jacksterb1234/Flight-Controller/Flight_Controller/Project_Outputs/Flight_Controller.pdf

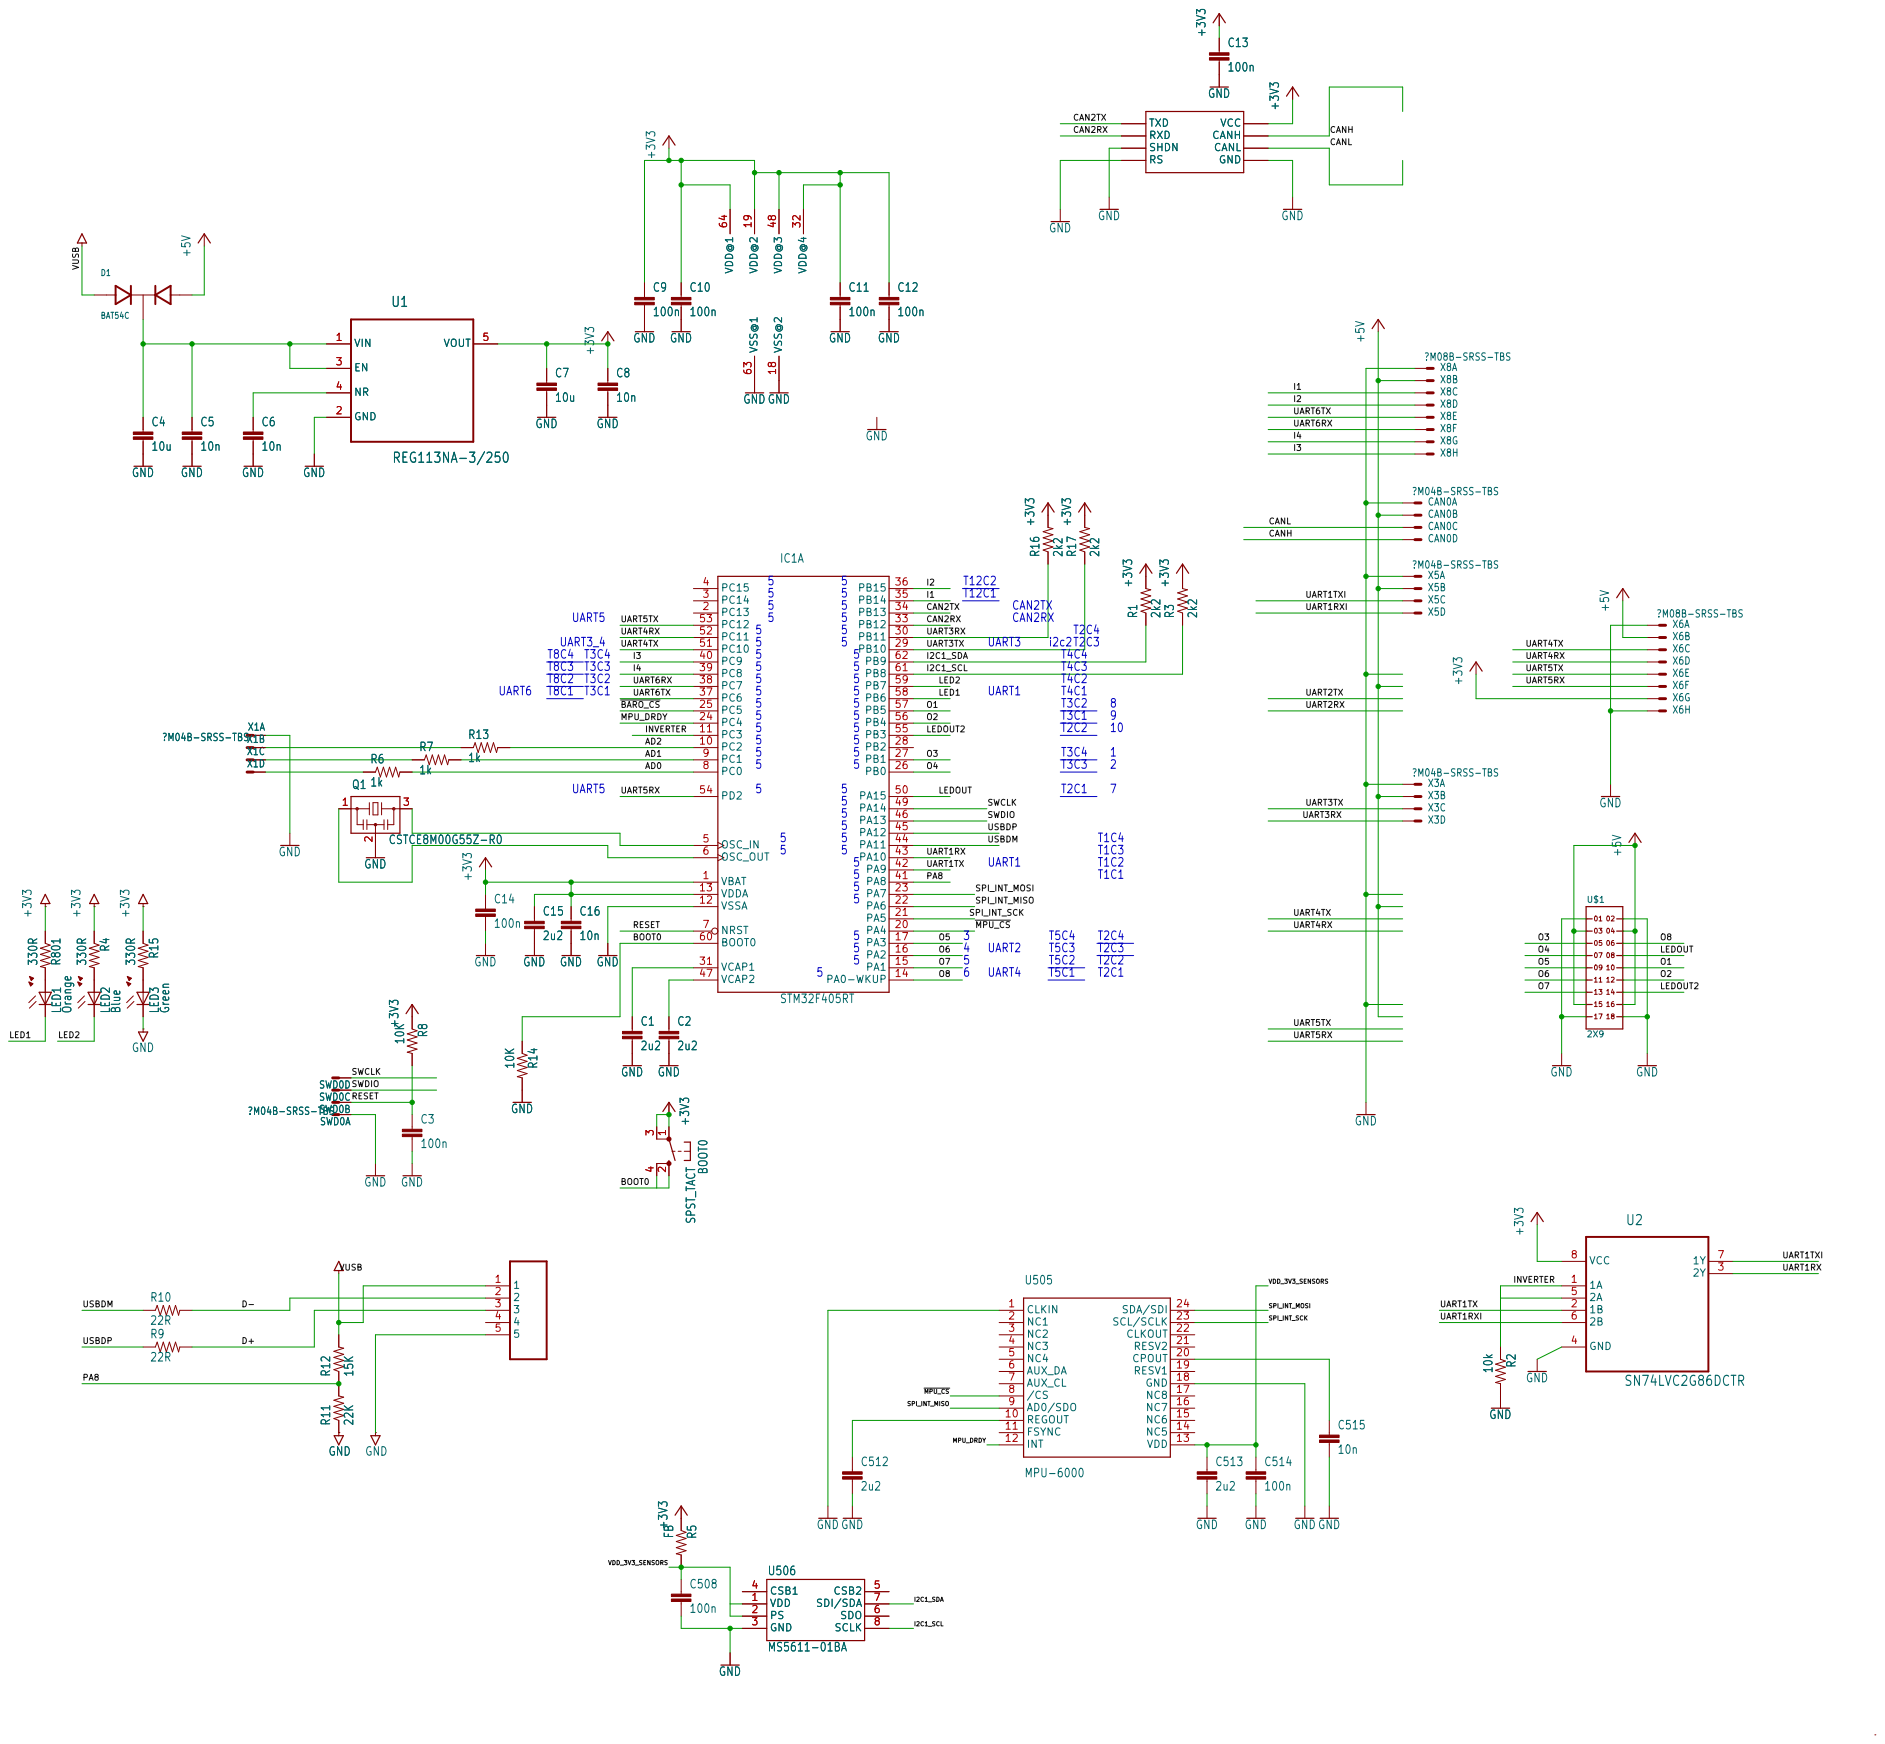
[picture p1: page 1]
