jacksterb1234/Flight-Controller/Flight_Controller/Flight_Controller.kicad_pcb

## KiCad design Flight_Controller/Flight_Controller.kicad_pcb (2026-09-02)

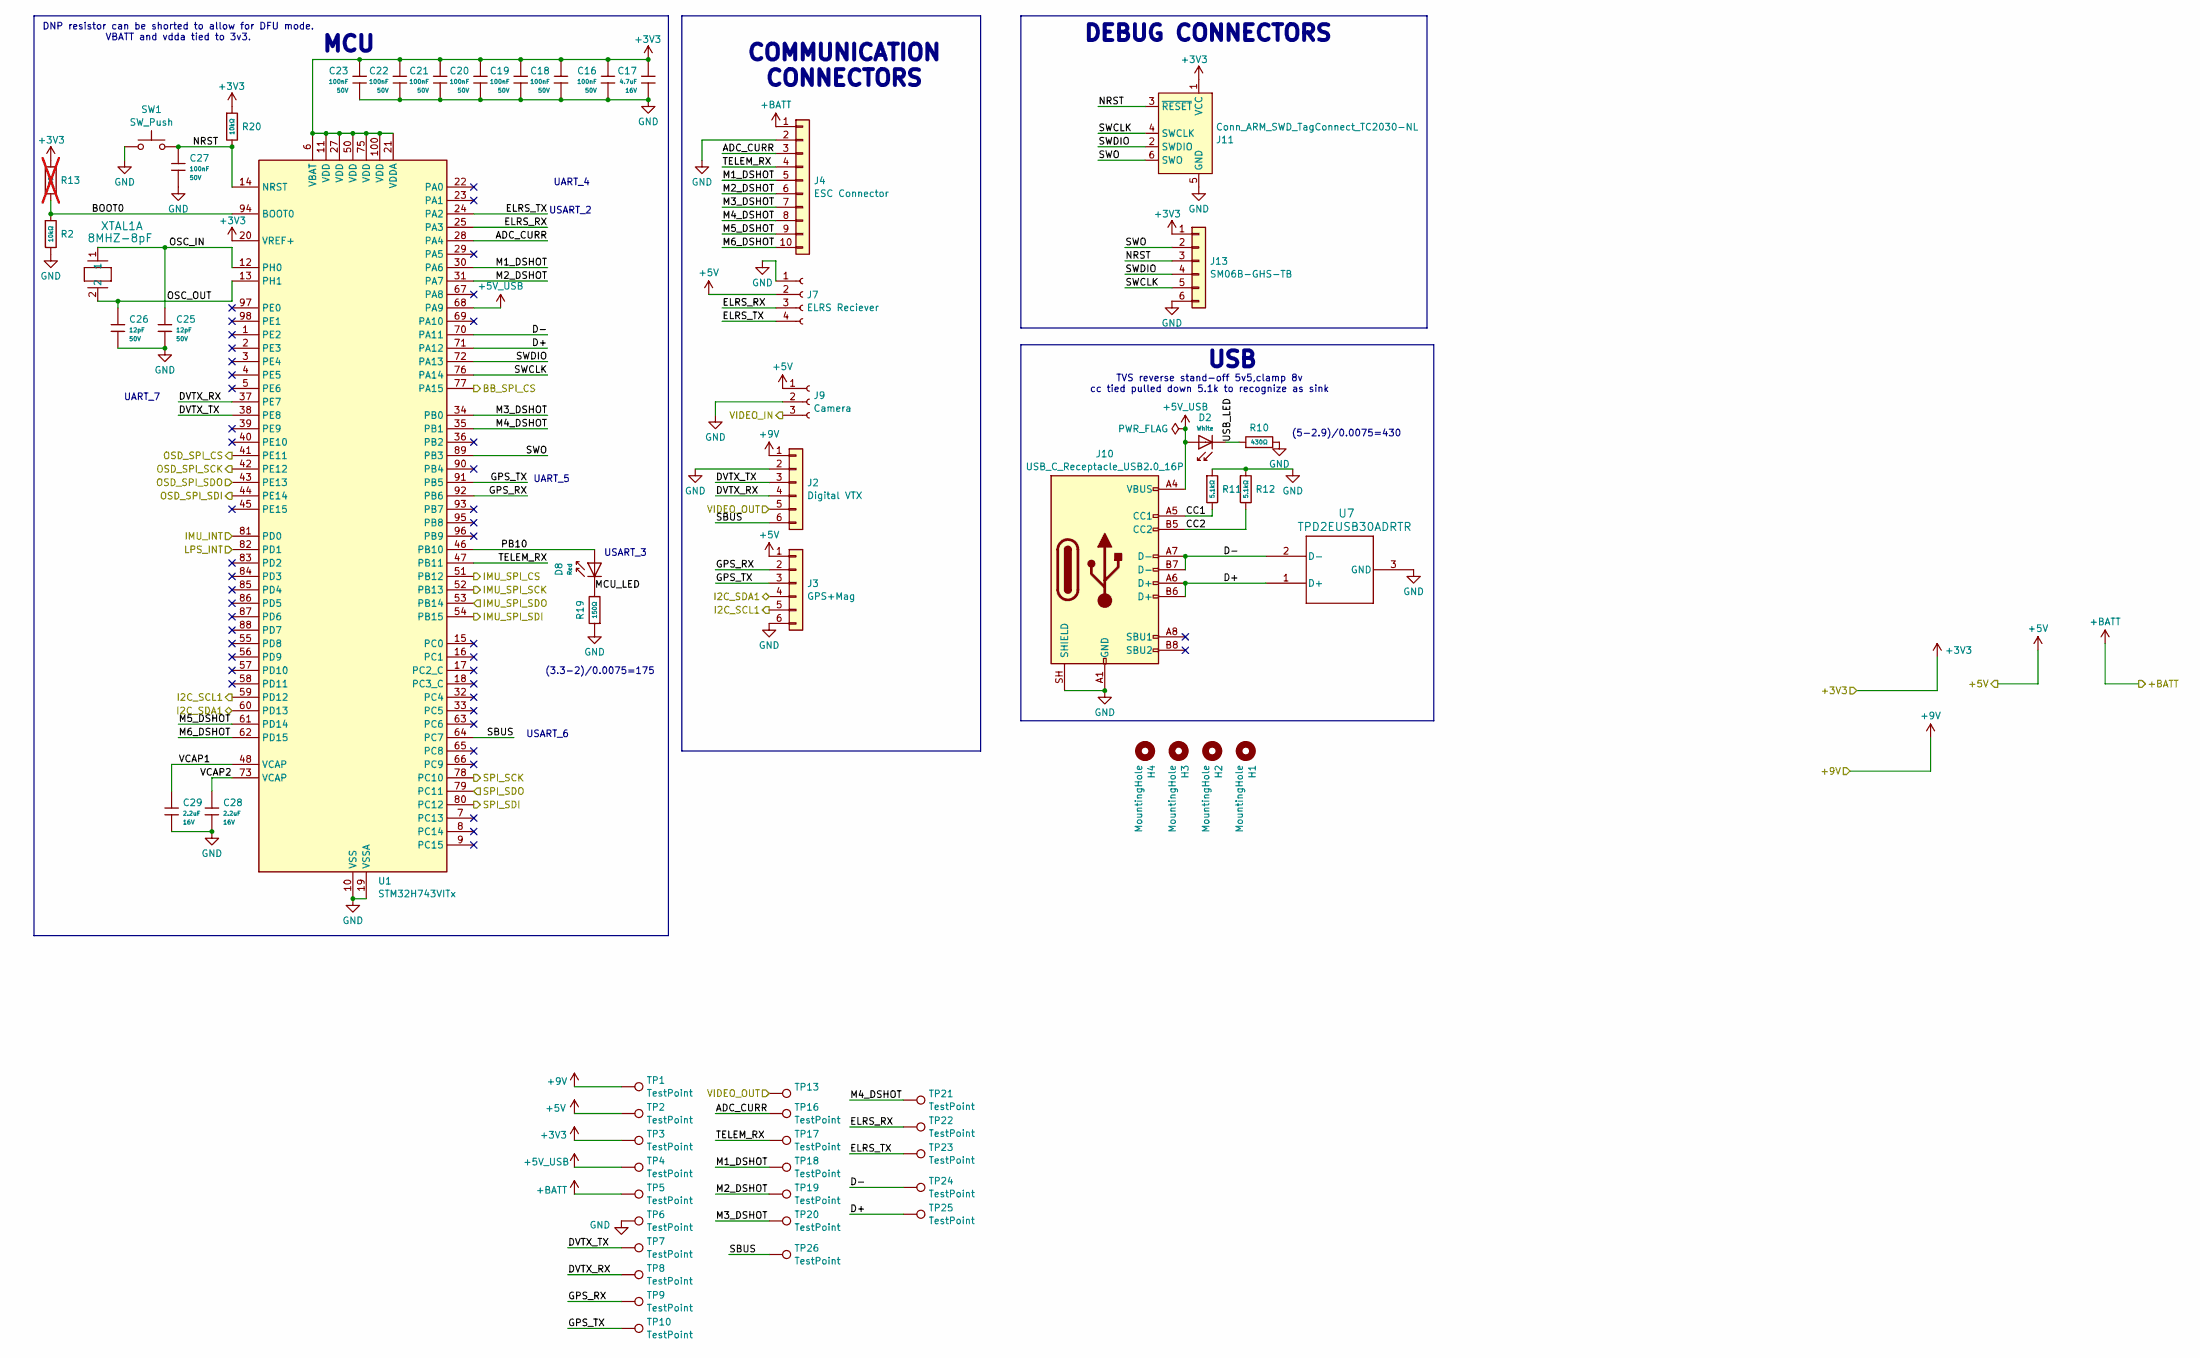
[picture p2: schematic MCU.kicad_sch]

Parts:
C16, C18, C19, C20, C21, C22, C23, C27: 100nF; C_0603; Voltage Rated 50V; Tolerance ±10%; Part CC0603KRX7R9BB104; LCSC C14663
C17: 4.7uF; C_0603; Voltage Rated 16V; Tolerance ±10%; Part CL10A475KO8NNNC; LCSC C19666
C25, C26: 12pF; C_0603; Voltage Rated 50V; Tolerance ±5%; Part CL10C120JB8NNNC; LCSC C38523
C28, C29: 2.2uF; C_0603; Voltage Rated 16V; Tolerance ±10%; Part CL10A225KO8NNNC; LCSC C23630
D2: White; D_0603; Part KT-0603W; LCSC C2290
D8: Red; D_0603; Part KT-0603R; LCSC C2286
H1, H2, H3, H4: MountingHole; MountingHole_3.2mm_M3_Pad_Via
J2: Digital VTX; JST_SH_SM06B-SRSS-TB_1x06-1MP_P1.00mm_Horizontal
J3: GPS+Mag; JST_SH_SM06B-SRSS-TB_1x06-1MP_P1.00mm_Horizontal
J4: ESC Connector; JST_SH_SM10B-SRSS-TB_1x10-1MP_P1.00mm_Horizontal
J7: ELRS Reciever; JST_SH_SM04B-SRSS-TB_1x04-1MP_P1.00mm_Horizontal
J9: Camera; JST_SH_SM03B-SRSS-TB_1x03-1MP_P1.00mm_Horizontal
J10: USB_C_Receptacle_USB2.0_16P; USB_C_Receptacle_GCT_USB4110
J11: Conn_ARM_SWD_TagConnect_TC2030-NL; Tag-Connect_TC2030-IDC-NL_2x03_P1.27mm_Vertical
J13: SM06B-GHS-TB; JST_GH_SM06B-GHS-TB_1x06-1MP_P1.25mm_Horizontal
R2, R20: 10kΩ; R_0603; Overload Voltage (Max) 75V; Tolerance ±1%; Part 0603WAF1002T5E; LCSC C25804
R10: 430Ω; R_0603; Overload Voltage (Max) 75V; Tolerance ±1%; Part 0603WAF4300T5E; LCSC C23170
R11, R12: 5.1kΩ; R_0603; Overload Voltage (Max) 75V; Tolerance ±1%; Part 0603WAF5101T5E; LCSC C23186
R13: 0Ω; R_0603; Overload Voltage (Max) 75V; Tolerance ±1%; Part 0603WAF0000T5E; LCSC C21189; not fitted
R19: 150Ω; R_0603; Overload Voltage (Max) 75V; Tolerance ±1%; Part 0603WAF1500T5E; LCSC C22808
SW1: SW_Push; SW_TS-1088-AR02016
TP1, TP2, TP3, TP4, TP5, TP6, TP7, TP8, TP9, TP10, TP13, TP16, TP17, TP18, TP19, TP20, TP21, TP22, TP23, TP24, TP25, TP26: TestPoint; TestPoint_Pad_D1.0mm
U1: STM32H743VITx; LQFP-100_14x14mm_P0.5mm
U7: TPD2EUSB30ADRTR; DRT3-L
XTAL1: 8MHZ-8pF; XTAL_NX3225GD-8MHZ-STD-CRA-3_NDK-L

Connections:
+3V3: C16.1, C17.1, C18.1, C19.1, C20.1, C21.1, C22.1, C23.1, J11.1 (VCC), J13.1, R13.1, R20.1, TP3.1 (1_1), U1.6 (VBAT), U1.11 (VDD), U1.20 (VREF+), U1.21 (VDDA), U1.27 (VDD), U1.50 (VDD), U1.75 (VDD), U1.100 (VDD); also elsewhere on the board
+5V: J3.1, J7.2, J9.1, TP2.1 (1_1); also elsewhere on the board
+5V_USB: D2.2, J10.A4 (VBUS), J10.A9 (VBUS), J10.B4 (VBUS), J10.B9 (VBUS), TP4.1 (1_1), U1.68 (PA9)
+9V: J2.1, TP1.1 (1_1); also elsewhere on the board
+BATT: J4.1, TP5.1 (1_1); also elsewhere on the board
/MCU/Connectors/ADC_CURR: J4.3, TP16.1 (1_1), U1.28 (PA4)
/MCU/Connectors/BB_SPI_CS: U1.77 (PA15); also elsewhere on the board
/MCU/Connectors/BOOT0: R2.1, R13.2, U1.94 (BOOT0)
/MCU/Connectors/CC1: J10.A5 (CC1), R11.2
/MCU/Connectors/CC2: J10.B5 (CC2), R12.2
/MCU/Connectors/D+: J10.A6 (D+), J10.B6 (D+), TP25.1 (1_1), U1.71 (PA12), U7.1 (D+)
/MCU/Connectors/D-: J10.A7 (D-), J10.B7 (D-), TP24.1 (1_1), U1.70 (PA11), U7.2 (D-)
/MCU/Connectors/DVTX_RX: J2.4, TP8.1 (1_1), U1.37 (PE7)
/MCU/Connectors/DVTX_TX: J2.3, TP7.1 (1_1), U1.38 (PE8)
/MCU/Connectors/ELRS_RX: J7.3, TP22.1 (1_1), U1.25 (PA3)
/MCU/Connectors/ELRS_TX: J7.4, TP23.1 (1_1), U1.24 (PA2)
/MCU/Connectors/GPS_RX: J3.2, TP9.1 (1_1), U1.92 (PB6)
/MCU/Connectors/GPS_TX: J3.3, TP10.1 (1_1), U1.91 (PB5)
/MCU/Connectors/I2C_SCL1: J3.5, U1.59 (PD12); also elsewhere on the board
/MCU/Connectors/I2C_SDA1: J3.4, U1.60 (PD13); also elsewhere on the board
/MCU/Connectors/IMU_INT: U1.81 (PD0); also elsewhere on the board
/MCU/Connectors/IMU_SPI_CS: U1.51 (PB12); also elsewhere on the board
/MCU/Connectors/IMU_SPI_SCK: U1.52 (PB13); also elsewhere on the board
/MCU/Connectors/IMU_SPI_SDI: U1.54 (PB15); also elsewhere on the board
/MCU/Connectors/IMU_SPI_SDO: U1.53 (PB14); also elsewhere on the board
/MCU/Connectors/LPS_INT: U1.82 (PD1); also elsewhere on the board
/MCU/Connectors/M1_DSHOT: J4.5, TP18.1 (1_1), U1.30 (PA6)
/MCU/Connectors/M2_DSHOT: J4.6, TP19.1 (1_1), U1.31 (PA7)
/MCU/Connectors/M3_DSHOT: J4.7, TP20.1 (1_1), U1.34 (PB0)
/MCU/Connectors/M4_DSHOT: J4.8, TP21.1 (1_1), U1.35 (PB1)
/MCU/Connectors/M5_DSHOT: J4.9, U1.61 (PD14)
/MCU/Connectors/M6_DSHOT: J4.10, U1.62 (PD15)
/MCU/Connectors/MCU_LED: D8.1, R19.2
/MCU/Connectors/NRST: C27.2, J11.3 (~RESET), J13.3, R20.2, SW1.2, U1.14 (NRST)
/MCU/Connectors/OSC_IN: C25.2, U1.12 (PH0), XTAL1.1
/MCU/Connectors/OSC_OUT: C26.2, U1.13 (PH1), XTAL1.2
/MCU/Connectors/OSD_SPI_CS: U1.41 (PE11); also elsewhere on the board
/MCU/Connectors/OSD_SPI_SCK: U1.42 (PE12); also elsewhere on the board
/MCU/Connectors/OSD_SPI_SDI: U1.44 (PE14); also elsewhere on the board
/MCU/Connectors/OSD_SPI_SDO: U1.43 (PE13); also elsewhere on the board
/MCU/Connectors/PB10: D8.2, U1.46 (PB10)
/MCU/Connectors/SBUS: J2.6, TP26.1 (1_1), U1.64 (PC7)
/MCU/Connectors/SPI_SCK: U1.78 (PC10); also elsewhere on the board
/MCU/Connectors/SPI_SDI: U1.80 (PC12); also elsewhere on the board
/MCU/Connectors/SPI_SDO: U1.79 (PC11); also elsewhere on the board
/MCU/Connectors/SWCLK: J11.4 (SWCLK), J13.5, U1.76 (PA14)
/MCU/Connectors/SWDIO: J11.2 (SWDIO), J13.4, U1.72 (PA13)
/MCU/Connectors/SWO: J11.6 (SWO), J13.2, U1.89 (PB3)
/MCU/Connectors/TELEM_RX: J4.4, TP17.1 (1_1), U1.47 (PB11)
/MCU/Connectors/USB_LED: D2.1, R10.1
/MCU/Connectors/VCAP1: C29.1, U1.48 (VCAP)
/MCU/Connectors/VCAP2: C28.1, U1.73 (VCAP)
/MCU/Connectors/VIDEO_IN: J9.3; also elsewhere on the board
/MCU/Connectors/VIDEO_OUT: J2.5, TP13.1 (1_1); also elsewhere on the board
GND: C16.2, C17.2, C18.2, C19.2, C20.2, C21.2, C22.2, C23.2, C25.1, C26.1, C27.1, C28.2, C29.2, J2.2, J3.6, J4.2, J7.1, J9.2, J10.A1 (GND), J10.A12 (GND), J10.B1 (GND), J10.B12 (GND), J10.SH (SHIELD), J11.5 (GND), J13.6, R2.2, R10.2, R11.1, R12.1, R19.1, SW1.1, TP6.1 (1_1), U1.10 (VSS), U1.19 (VSSA), U1.26 (VSS), U1.49 (VSS), U1.74 (VSS), U1.99 (VSS), U7.3 (GND); also elsewhere on the board

Notes on the sheet:
UART_4
UART_7
TVS reverse stand-off 5v5,clamp 8v cc tied pulled down 5.1k to recognize as sink
UART_5
COMMUNICATION CONNECTORS
(5-2.9)/0.0075=430
USART_3
USB
(3.3-2)/0.0075=175
MCU
USART_6
DEBUG CONNECTORS
USART_2
DNP resistor can be shorted to allow for DFU mode. VBATT and vdda tied to 3v3.

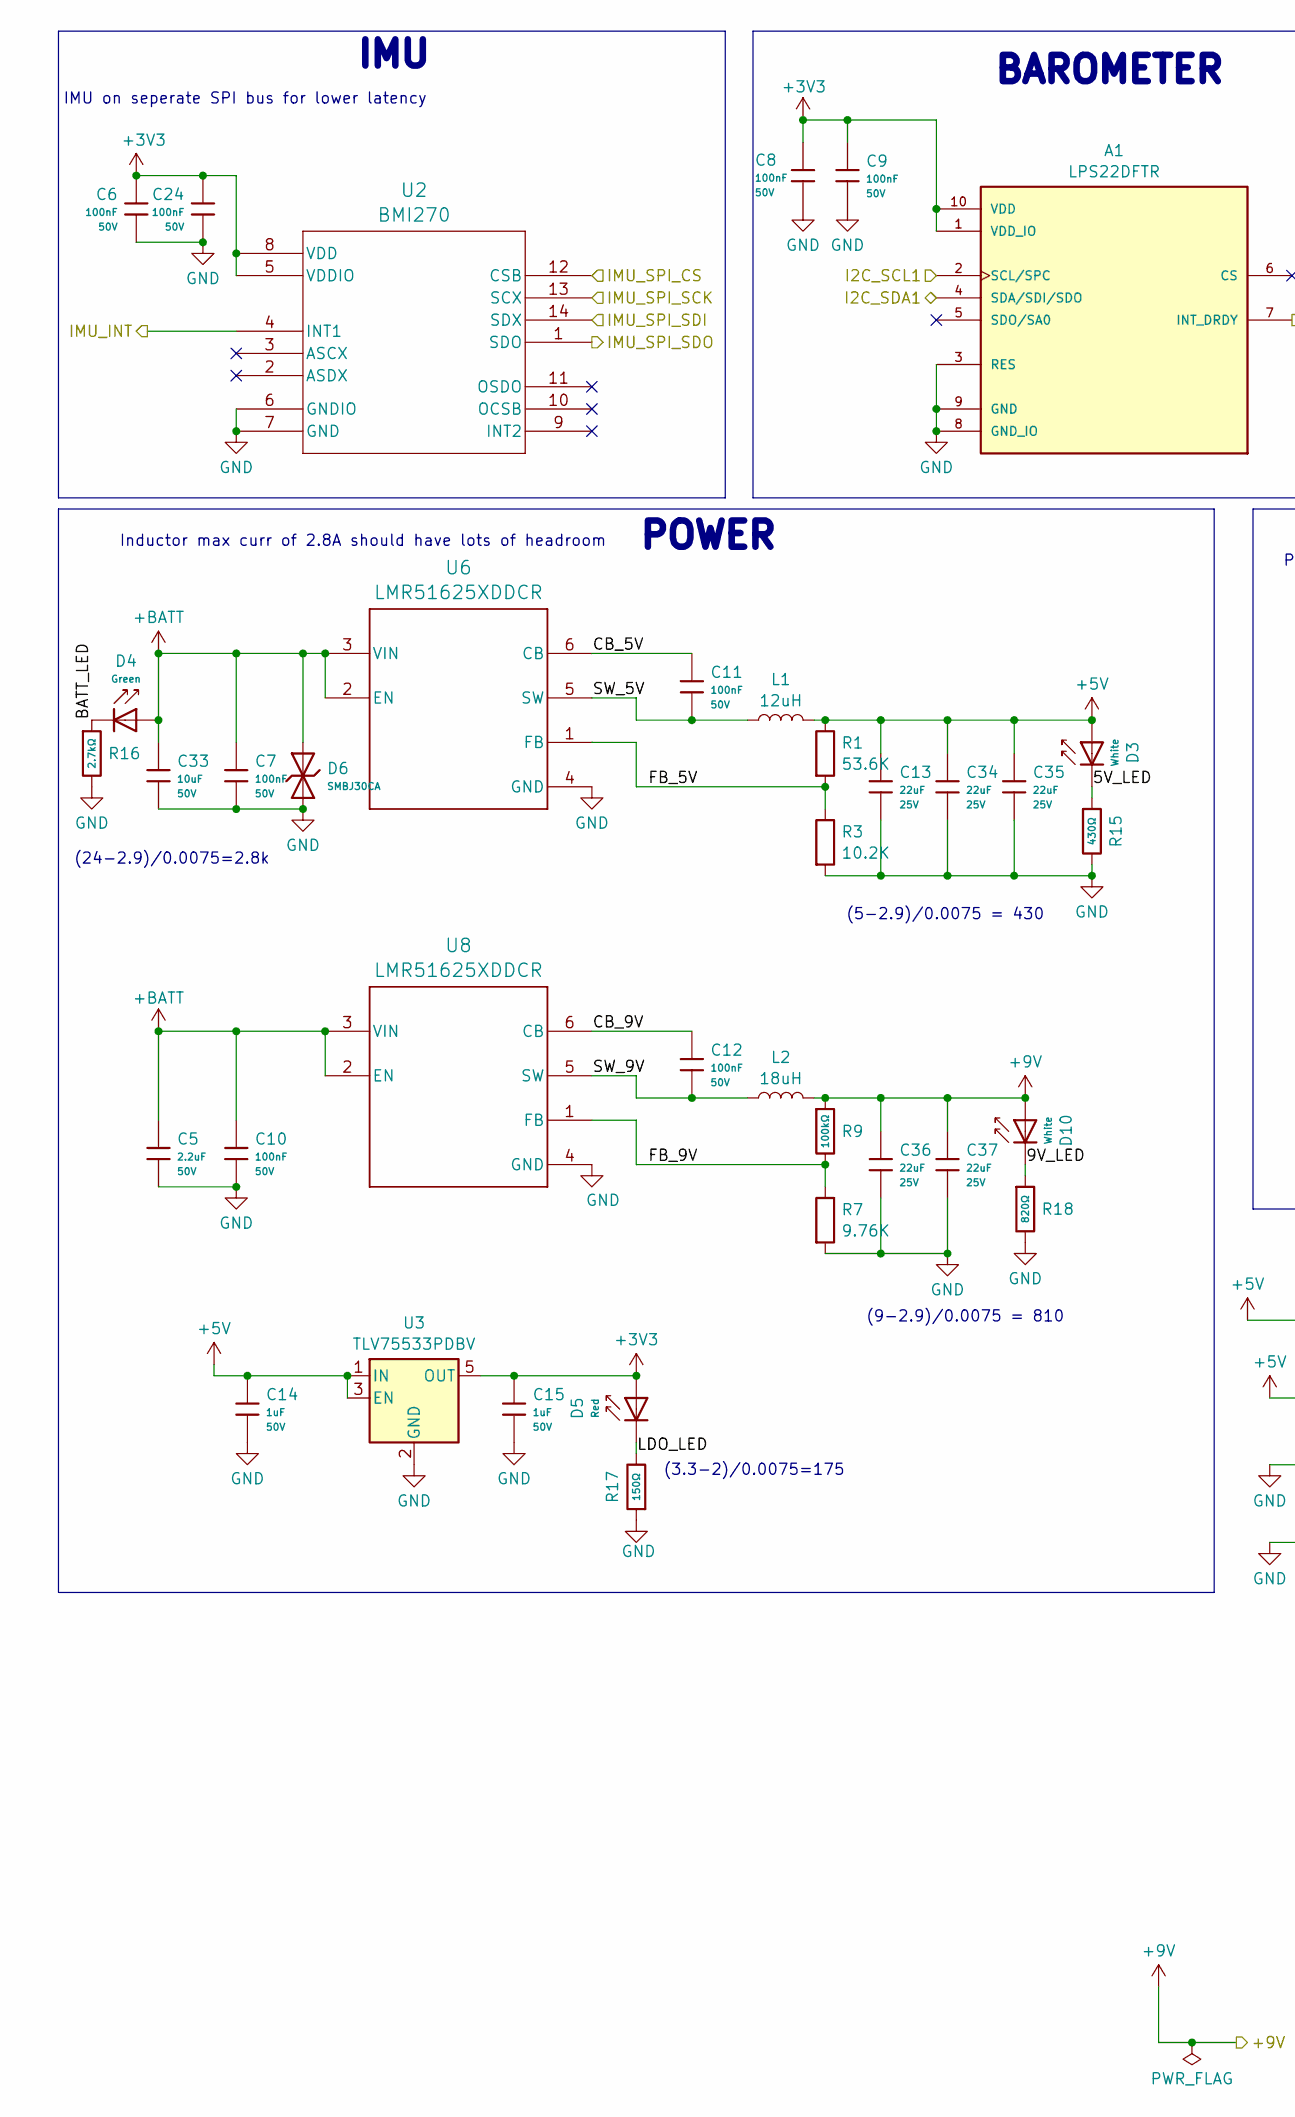
[picture p3: schematic Peripherals.kicad_sch, part in row 1, column 1]

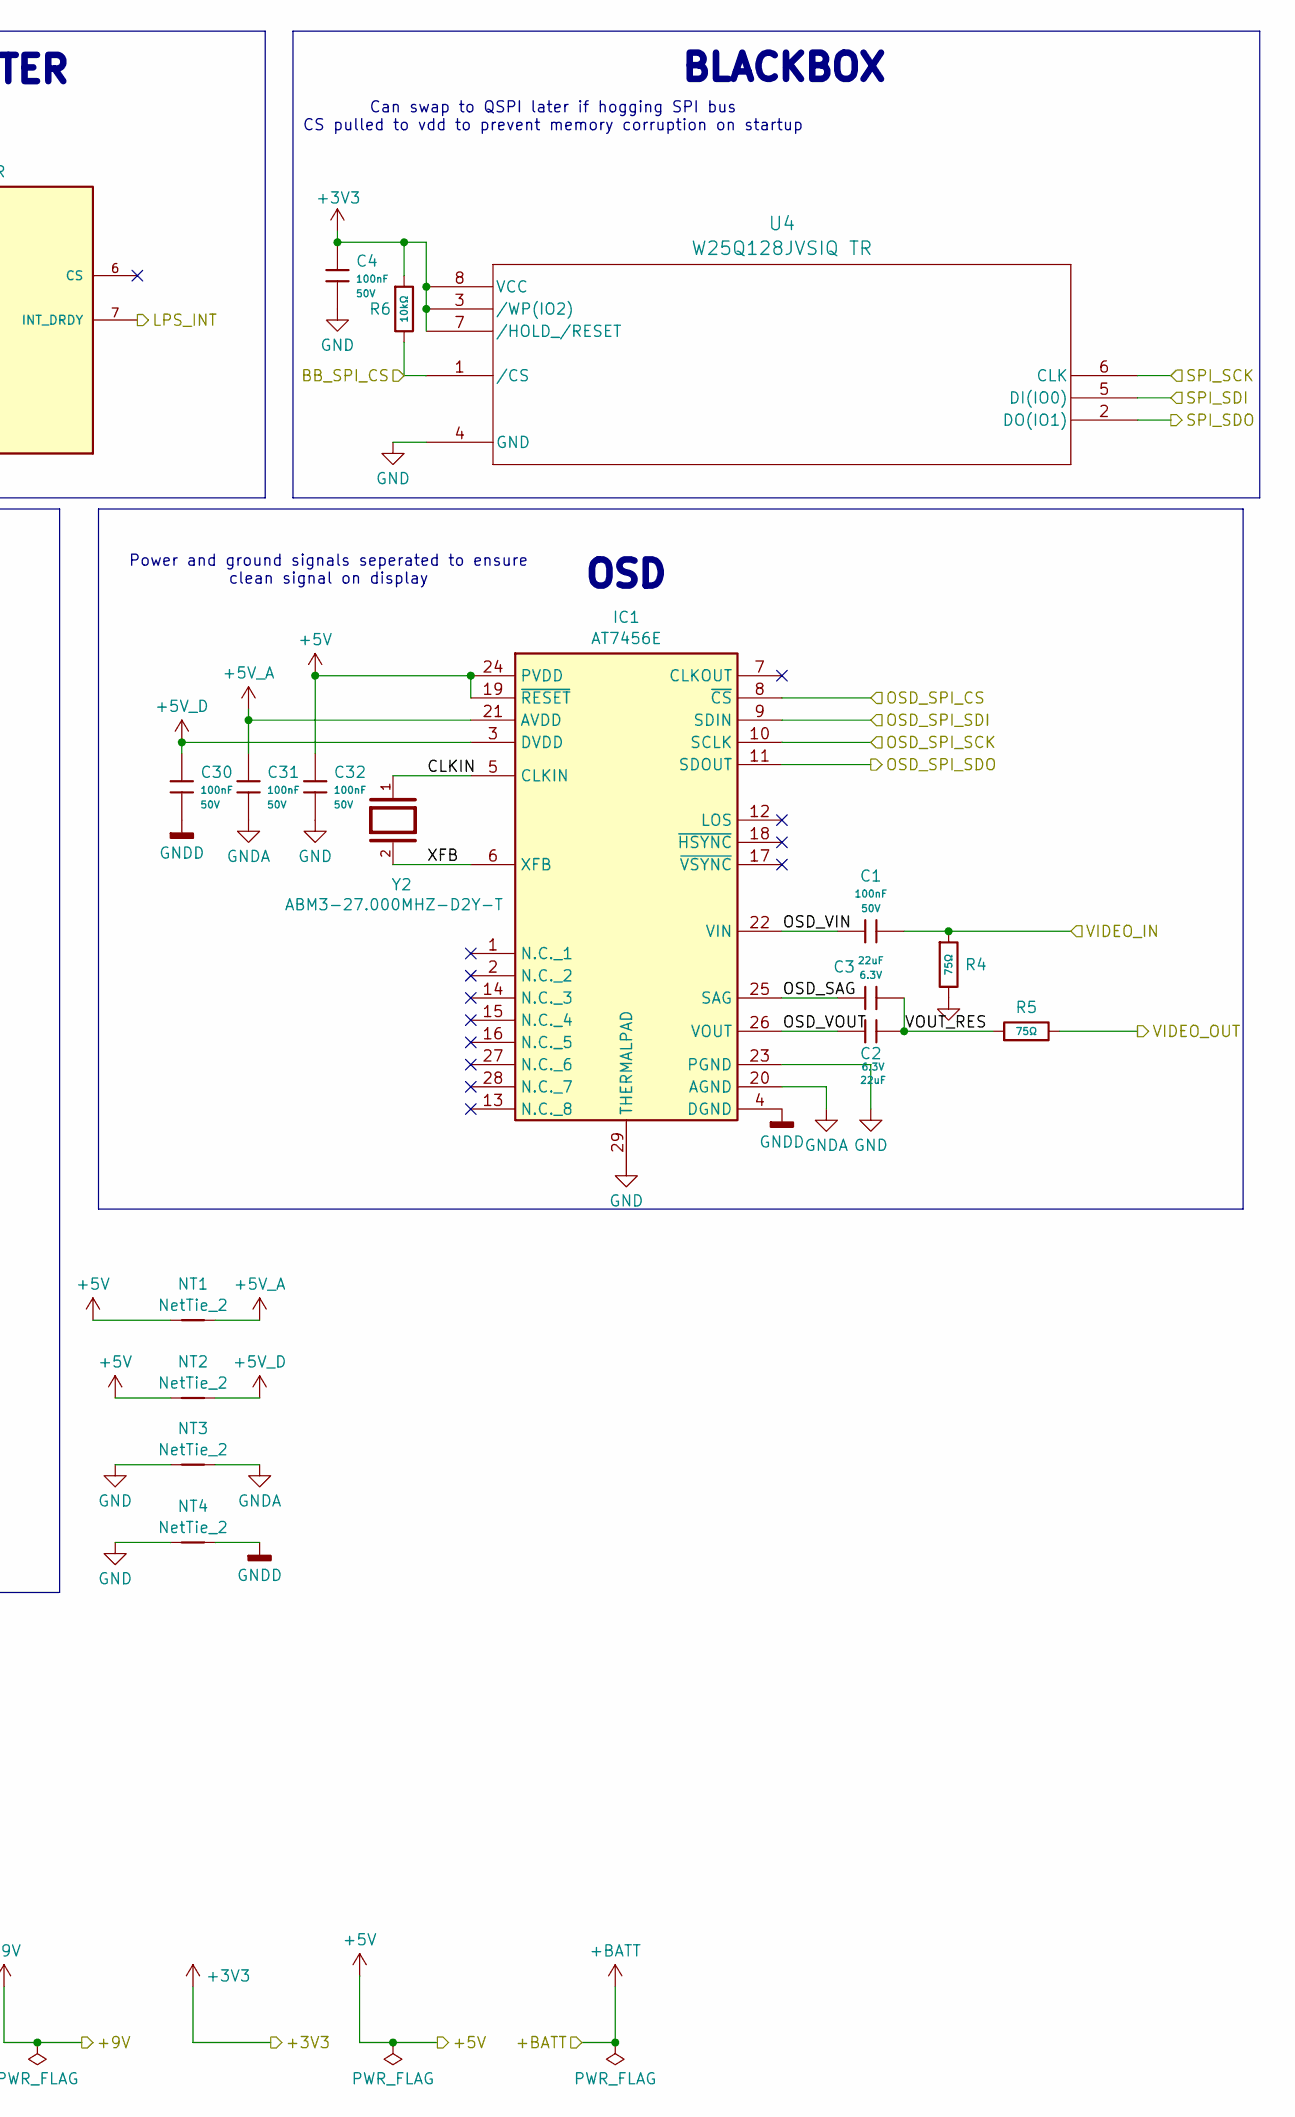
[picture p4: schematic Peripherals.kicad_sch, part in row 1, column 2]

Parts:
A1: LPS22DFTR; XDCR_LPS22DFTR; PARTREV 3
C1, C4, C6, C7, C8, C9, C10, C11, C12, C24, C30, C31, C32: 100nF; C_0603; Voltage Rated 50V; Tolerance ±10%; Part CC0603KRX7R9BB104; LCSC C14663
C2, C3: 22uF; C_0603; Voltage Rated 6.3V; Tolerance ±20%; Part CL10A226MQ8NRNC; LCSC C59461
C5: 2.2uF; C_0805; Voltage Rated 50V; Tolerance ±10%; Part CL21A225KBQNNNE; LCSC C377773
C13, C34, C35, C36, C37: 22uF; C_1206; Voltage Rated 25V; Tolerance ±10%; Part CL31A226KAHNNNE; LCSC C12891
C14, C15: 1uF; C_0603; Voltage Rated 50V; Tolerance ±10%; Part CL10A105KB8NNNC; LCSC C15849
C33: 10uF; C_0805; Voltage Rated 50V; Tolerance ±10%; Part GRM21BR61H106KE43L; LCSC C440198
D3, D10: White; D_0603; Part KT-0603W; LCSC C2290
D4: Green; D_0805; Part KT-0805G; LCSC C2297
D5: Red; D_0603; Part KT-0603R; LCSC C2286
D6: SMBJ30CA; D_SMB; Clamping Voltage 48.4V; Voltage - Breakdown 36.8V; Part SMBJ30CA; LCSC C19077585
IC1: AT7456E; SOP65P640X120-29N; Manufacturer_Part_Number AT7456E
L1: 12uH; L_TDK_VLS6045EX_VLS6045AF
L2: 18uH; L_TDK_VLP8040
NT1, NT2, NT3, NT4: NetTie_2; NetTie-2_SMD_Pad0.5mm
R1: 53.6K; R_0603
R3: 10.2K; R_0603
R4, R5: 75Ω; R_0603; Overload Voltage (Max) 75V; Tolerance ±1%; Part 0603WAF750JT5E; LCSC C4275
R6: 10kΩ; R_0603; Overload Voltage (Max) 75V; Tolerance ±1%; Part 0603WAF1002T5E; LCSC C25804
R7: 9.76K; R_0603
R9: 100kΩ; R_0603; Overload Voltage (Max) 75V; Tolerance ±1%; Part 0603WAF1003T5E; LCSC C25803
R15: 430Ω; R_0603; Overload Voltage (Max) 75V; Tolerance ±1%; Part 0603WAF4300T5E; LCSC C23170
R16: 2.7kΩ; R_0603; Overload Voltage (Max) 75V; Tolerance ±1%; Part 0603WAF2701T5E; LCSC C13167
R17: 150Ω; R_0603; Overload Voltage (Max) 75V; Tolerance ±1%; Part 0603WAF1500T5E; LCSC C22808
R18: 820Ω; R_0603; Overload Voltage (Max) 75V; Tolerance ±1%; Part 0603WAF8200T5E; LCSC C23253
U2: BMI270; BMI270_BOS-L
U3: TLV75533PDBV; SOT-23-5
U4: W25Q128JVSIQ TR; SOIC_208MIL_WIN-L
U6, U8: LMR51625XDDCR; DDC0006A-MFG
Y2: ABM3-27.000MHZ-D2Y-T; XTAL_ABM3-27.000MHZ-D2Y-T; PARTREV 4/25/2022

Connections:
+3V3: A1.1 (VDD_IO), A1.10 (VDD), C4.1, C6.1, C8.1, C9.1, C15.1, C24.1, D5.2, R6.1, U2.5 (VDDIO), U2.8 (VDD), U3.5 (OUT), U4.3 (/WP(IO2)), U4.7 (/HOLD_/RESET), U4.8 (VCC); also elsewhere on the board
+5V: C13.1, C14.1, C32.1, C34.1, C35.1, D3.2, IC1.19 (~RESET), IC1.24 (PVDD), L1.2, NT1.2, NT2.2, R1.1, U3.1 (IN), U3.3 (EN); also elsewhere on the board
+5V_A: C31.1, IC1.21 (AVDD), NT1.1
+5V_D: C30.1, IC1.3 (DVDD), NT2.1
+9V: C36.1, C37.1, D10.2, L2.2, R9.1; also elsewhere on the board
+BATT: C5.1, C7.1, C10.1, C33.1, D4.2, D6.2, U6.2 (EN), U6.3 (VIN), U8.2 (EN), U8.3 (VIN); also elsewhere on the board
/MCU/Connectors/BB_SPI_CS: R6.2, U4.1 (/CS); also elsewhere on the board
/MCU/Connectors/I2C_SCL1: A1.2 (SCL/SPC); also elsewhere on the board
/MCU/Connectors/I2C_SDA1: A1.4 (SDA/SDI/SDO); also elsewhere on the board
/MCU/Connectors/IMU_INT: U2.4 (INT1); also elsewhere on the board
/MCU/Connectors/IMU_SPI_CS: U2.12 (CSB); also elsewhere on the board
/MCU/Connectors/IMU_SPI_SCK: U2.13 (SCX); also elsewhere on the board
/MCU/Connectors/IMU_SPI_SDI: U2.14 (SDX); also elsewhere on the board
/MCU/Connectors/IMU_SPI_SDO: U2.1 (SDO); also elsewhere on the board
/MCU/Connectors/LPS_INT: A1.7 (INT_DRDY); also elsewhere on the board
/MCU/Connectors/OSD_SPI_CS: IC1.8 (~CS); also elsewhere on the board
/MCU/Connectors/OSD_SPI_SCK: IC1.10 (SCLK); also elsewhere on the board
/MCU/Connectors/OSD_SPI_SDI: IC1.9 (SDIN); also elsewhere on the board
/MCU/Connectors/OSD_SPI_SDO: IC1.11 (SDOUT); also elsewhere on the board
/MCU/Connectors/SPI_SCK: U4.6 (CLK); also elsewhere on the board
/MCU/Connectors/SPI_SDI: U4.5 (DI(IO0)); also elsewhere on the board
/MCU/Connectors/SPI_SDO: U4.2 (DO(IO1)); also elsewhere on the board
/MCU/Connectors/VIDEO_IN: C1.2, R4.1; also elsewhere on the board
/MCU/Connectors/VIDEO_OUT: R5.2; also elsewhere on the board
/Peripherals/Power/5V_LED: D3.1, R15.1
/Peripherals/Power/9V_LED: D10.1, R18.1
/Peripherals/Power/BATT_LED: D4.1, R16.1
/Peripherals/Power/CB_5V: C11.1, U6.6 (CB)
/Peripherals/Power/CB_9V: C12.1, U8.6 (CB)
/Peripherals/Power/CLKIN: IC1.5 (CLKIN), Y2.1
/Peripherals/Power/FB_5V: R1.2, R3.1, U6.1 (FB)
/Peripherals/Power/FB_9V: R7.1, R9.2, U8.1 (FB)
/Peripherals/Power/LDO_LED: D5.1, R17.2
/Peripherals/Power/OSD_SAG: C3.1, IC1.25 (SAG)
/Peripherals/Power/OSD_VIN: C1.1, IC1.22 (VIN)
/Peripherals/Power/OSD_VOUT: C2.1, IC1.26 (VOUT)
/Peripherals/Power/SW_5V: C11.2, L1.1, U6.5 (SW)
/Peripherals/Power/SW_9V: C12.2, L2.1, U8.5 (SW)
/Peripherals/Power/VOUT_RES: C2.2, C3.2, R5.1
/Peripherals/Power/XFB: IC1.6 (XFB), Y2.2
GND: A1.3 (RES), A1.8 (GND_IO), A1.9 (GND), C4.2, C5.2, C6.2, C7.2, C8.2, C9.2, C10.2, C13.2, C14.2, C15.2, C24.2, C32.2, C33.2, C34.2, C35.2, C36.2, C37.2, D6.1, IC1.23 (PGND), IC1.29 (THERMALPAD), NT3.2, NT4.2, R3.2, R4.2, R7.2, R15.2, R16.2, R17.1, R18.2, U2.6 (GNDIO), U2.7 (GND), U3.2 (GND), U4.4 (GND), U6.4 (GND), U8.4 (GND); also elsewhere on the board
GNDA: C31.2, IC1.20 (AGND), NT3.1
GNDD: C30.2, IC1.4 (DGND), NT4.1

Notes on the sheet:
Inductor max curr of 2.8A should have lots of headroom
(5-2.9)/0.0075 = 430
(24-2.9)/0.0075=2.8k
Can swap to QSPI later if hogging SPI bus CS pulled to vdd to prevent memory corruption on startup
Power and ground signals seperated to ensure clean signal on display
(3.3-2)/0.0075=175
POWER
IMU on seperate SPI bus for lower latency
OSD
(9-2.9)/0.0075 = 810
IMU
BAROMETER
BLACKBOX

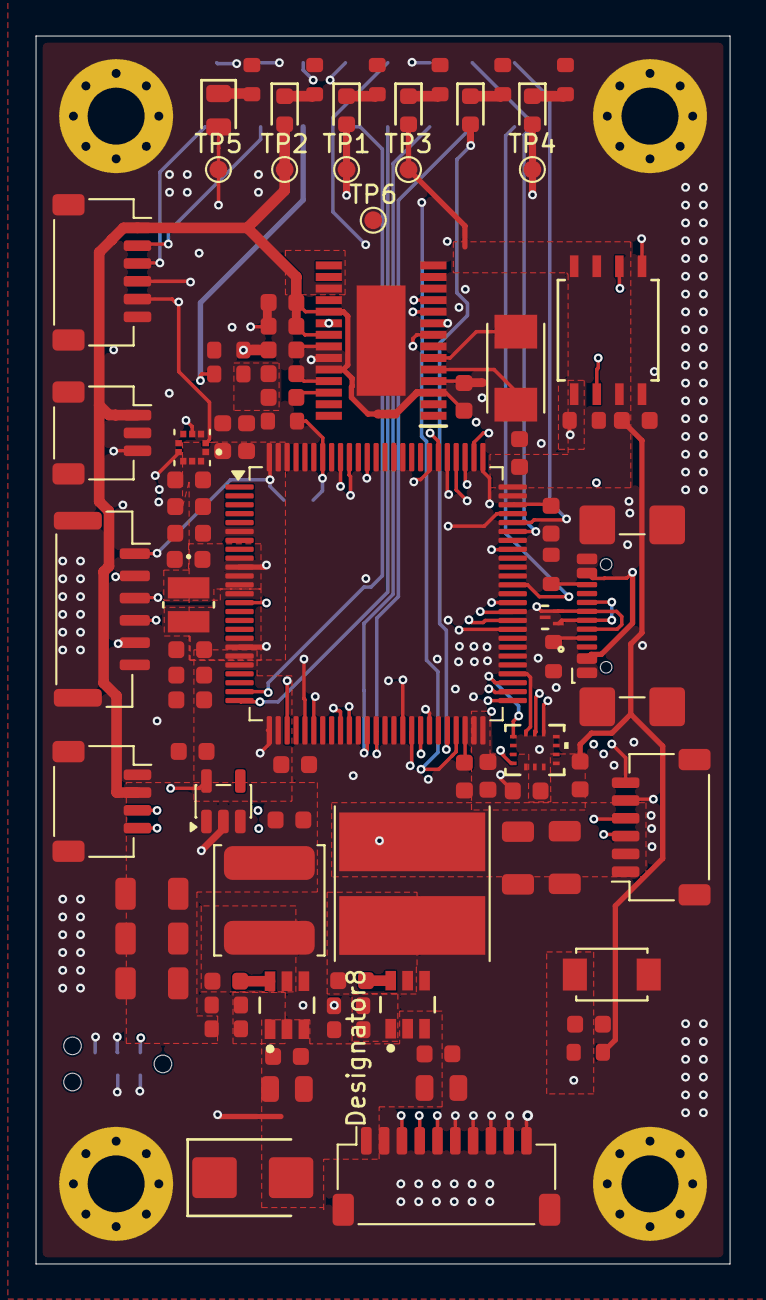
[picture p5: board Flight_Controller.kicad_pcb from above]

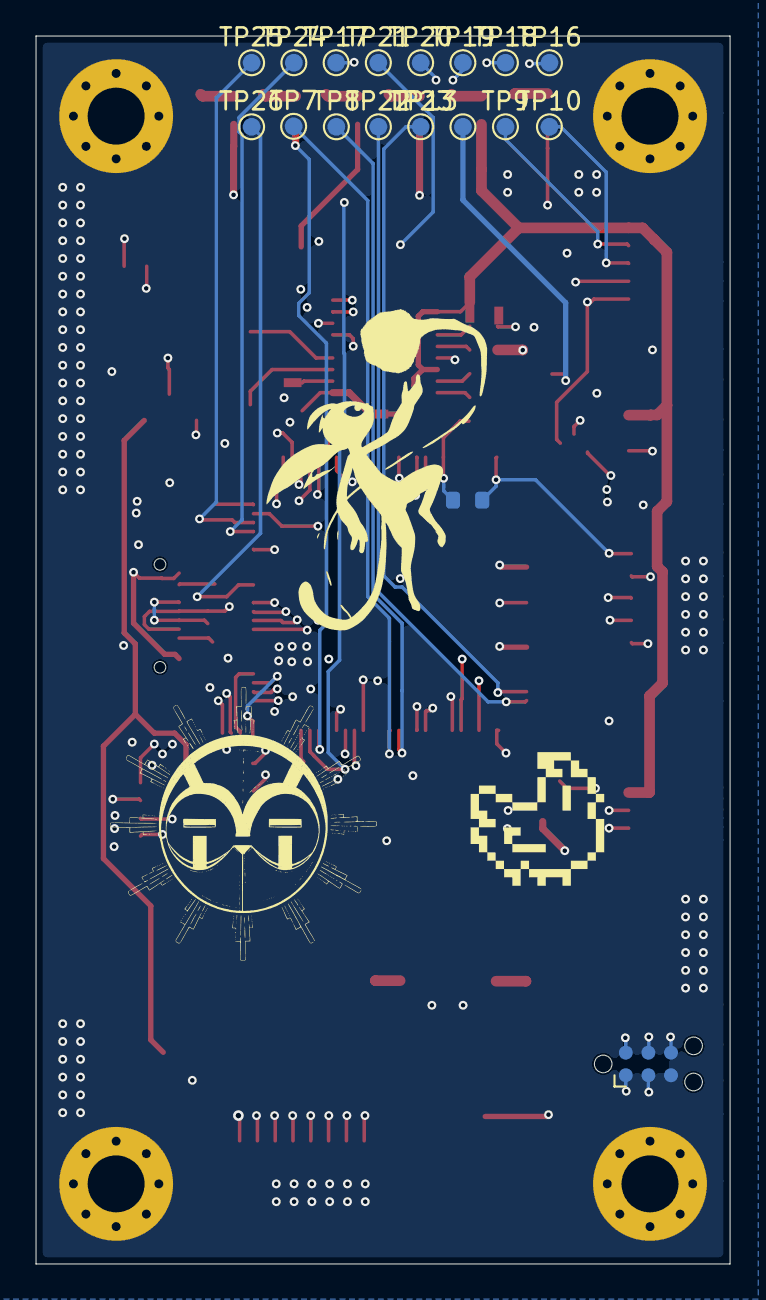
[picture p6: board Flight_Controller.kicad_pcb from below]

Board: 4 copper layers, 39.0 x 69.0 mm, 114 parts (18 on the bottom side), 75 nets.
