jacksterb1234/Flight-Controller/(commit log)

2026-07-16 Inital Commit
    [fc_component_matrix.csv, fc_selected_component_matrix.csv]
2026-08-08 Schem Periphs
    [Flight_Controller.kicad_pcb, Flight_Controller.kicad_sch, MCU.kicad_sch, Peripherals.kicad_sch, Power.kicad_sch, architecture.kicad_sch]
2026-08-08 Schem V1 Done!
    [Flight_Controller.kicad_sch, MCU.kicad_sch, Peripherals.kicad_sch, Power.kicad_sch, architecture.kicad_sch]
2026-08-09 Fixed ERC errors
    [MCU.kicad_sch, Peripherals.kicad_sch]
2026-08-09 Set footprints
    [Flight_Controller.kicad_pcb, Flight_Controller.kicad_sch, MCU.kicad_sch, Peripherals.kicad_sch]
2026-08-09 Made schem look nicer
    [Flight_Controller.kicad_sch, Peripherals.kicad_sch]
2026-08-15 PCB clustering
    [Flight_Controller.kicad_pcb]
2026-08-16 Added labels in schem
    [MCU.kicad_sch, Peripherals.kicad_sch]
2026-08-16 Rough Layout + LEDs
    [Flight_Controller.kicad_pcb, Power.kicad_sch, architecture.kicad_sch, fc_component_matrix.csv, fc_selected_component_matrix.csv]
2026-08-16 Updated buck for 60v spike
    [MCU.kicad_sch, Peripherals.kicad_sch]
2026-08-21 Initial Layout Done
    [Flight_Controller.kicad_pcb, MCU.kicad_sch, Peripherals.kicad_sch]
2026-08-21 Layout V2
    [Flight_Controller.kicad_pcb]
2026-08-26 Updated Connector Standard
    [Flight_Controller.kicad_pcb, MCU.kicad_sch]
2026-08-26 Added 9V Buck, GPS + Mag, Digital VTX
    [MCU.kicad_sch, Peripherals.kicad_sch]
2026-08-27 Updated Footprints
    [Flight_Controller.kicad_pcb, Flight_Controller.kicad_sch, MCU.kicad_sch, Peripherals.kicad_sch]
2026-08-28 Updated Layout to 60x30
    [Flight_Controller.kicad_pcb, MCU.kicad_sch, Peripherals.kicad_sch]
2026-08-28 More Layout Updates
    [Flight_Controller.kicad_pcb]
2026-08-31 Almost Done Routing!
    [Flight_Controller.kicad_pcb, MCU.kicad_sch]
2026-09-02 Routing Done!
    [Flight_Controller.kicad_pcb, Flight_Controller.kicad_sch, MCU.kicad_sch, Peripherals.kicad_sch]
